akifyucedag/AEA_BMS/istikrar bmsarka.png

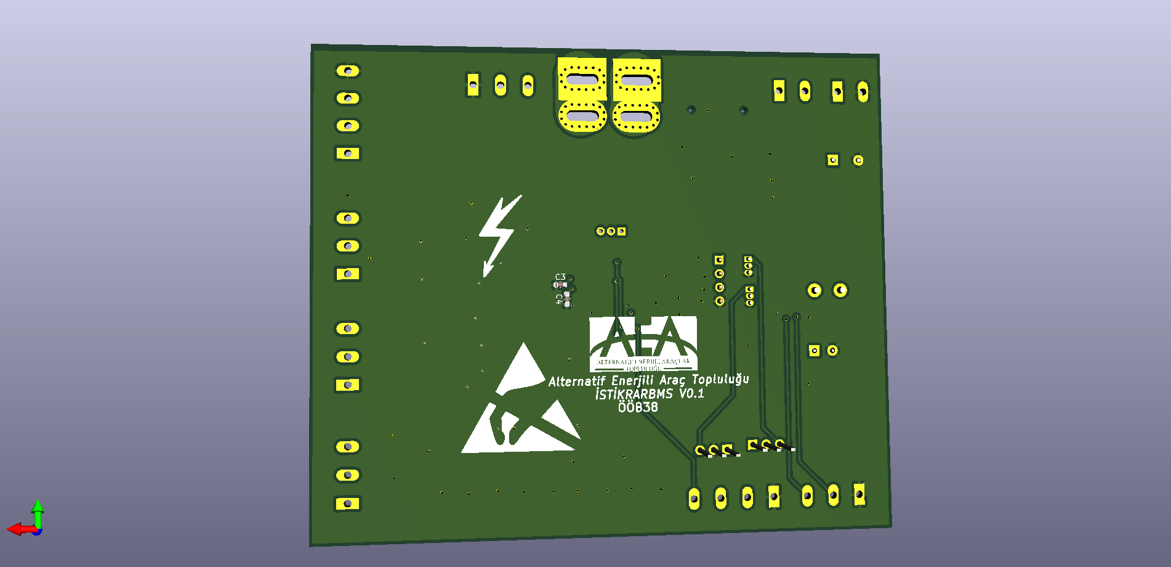
istikrar bmsarka.png
