akifyucedag/AEA_BMS/README.md

# AEA_BMS
iskenderun teknik üniversite  Alternatif araç topluluğu için hazırlamış olduğum 12s bms kartı
