akifyucedag/AEA_BMS/malzeme listesi 2.xlsx

reference | value | footprint | datashet |  |  |  |  | LİNK | QTY
C3 | 1uf63v | Capacitor_SMD:C_0603_1608Metric | ~ |  |  |  |  | https://ozdisan.com/pasif-komponentler/kondansatorler/smt-smd-ve-mlcc-kondansatorler/CL10A105KA8NNNC | 2 | o | t
C4 | 1uf63v | Capacitor_SMD:C_0603_1608Metric_Pad1.08x0.95mm_HandSolder | ~ |  |  |  |  | https://ozdisan.com/pasif-komponentler/kondansatorler/smt-smd-ve-mlcc-kondansatorler/CL10A105KA8NNNC | 2 | o | t
> C6, C8 | 18pf | Capacitor_SMD:C_0805_2012Metric_Pad1.18x1.45mm_HandSolder | ~ |  |  |  |  | https://www.ozdisan.com/pasif-komponentler/kondansatorler/smt-smd-ve-mlcc-kondansatorler/CL03C180GA3GNNC | 4 | o | t
> C1, C2, C5, C9 | 100nf | Capacitor_SMD:C_0603_1608Metric_Pad1.08x0.95mm_HandSolder | ~ |  |  |  |  | PRODUCT (https://www.ozdisan.com/pasif-komponentler/kondansatorler/smt-smd-ve-mlcc-kondansatorler/CL03C180GA3GNNC) | 6 | o | t
> C16, C29, C30 | 1uf | Capacitor_SMD:C_0603_1608Metric | ~ |  |  |  |  | PRODUCT (https://www.ozdisan.com/pasif-komponentler/kondansatorler/smt-smd-ve-mlcc-kondansatorler/CL10B105KQ8VPJC) | 5 | o | d
C18 | 10nf100v | Capacitor_SMD:C_1206_3216Metric_Pad1.33x1.80mm_HandSolder | ~ |  |  |  |  | https://ozdisan.com/pasif-komponentler/kondansatorler/smt-smd-ve-mlcc-kondansatorler/CL31B103KCCNNNC | 3 | o | d
> C15, C20, C35 | 10uf10V | Capacitor_SMD:C_0805_2012Metric_Pad1.18x1.45mm_HandSolder | ~ |  |  |  |  | PRODUCT (https://www.ozdisan.com/pasif-komponentler/kondansatorler/smt-smd-ve-mlcc-kondansatorler/CL21A106KPFNNNE) | 5 | o | d
> C10, C14, C25 | 100nf | Capacitor_SMD:C_1206_3216Metric_Pad1.33x1.80mm_HandSolder | ~ |  |  |  |  | PRODUCT (https://www.ozdisan.com/pasif-komponentler/kondansatorler/smt-smd-ve-mlcc-kondansatorler/CL31B104KBCNNND) | 5 | o | ş
C26 | 330uf | Capacitor_THT:CP_Radial_D10.0mm_P3.50mm | ~ |  |  |  |  |  | 2 | o | d
C31 | 100nf100v | Capacitor_SMD:C_1206_3216Metric_Pad1.33x1.80mm_HandSolder | ~ |  |  |  |  | PRODUCT (https://www.ozdisan.com/pasif-komponentler/kondansatorler/smt-smd-ve-mlcc-kondansatorler/CL31B104KCFNNNE) | 2 | o
> C7, C12, C13, C17, C19, C22-C24, C27, C28, C32 | 100nf100v | Capacitor_SMD:C_1206_3216Metric_Pad1.33x1.80mm_HandSolder | ~ |  |  |  |  | PRODUCT (https://www.ozdisan.com/pasif-komponentler/kondansatorler/smt-smd-ve-mlcc-kondansatorler/CL31B104KCFNNNE) | 15 | o
C33 | 100nf 100v | Capacitor_SMD:C_1206_3216Metric_Pad1.33x1.80mm_HandSolder | ~ |  |  |  |  | PRODUCT (https://www.ozdisan.com/pasif-komponentler/kondansatorler/smt-smd-ve-mlcc-kondansatorler/CL31B104KCFNNNE) | 2 | o
> C11, C34 | 100nf 25v | Capacitor_SMD:C_1206_3216Metric_Pad1.33x1.80mm_HandSolder | ~ |  |  |  |  | PRODUCT (https://www.ozdisan.com/pasif-komponentler/kondansatorler/smt-smd-ve-mlcc-kondansatorler/CL31B104KCFNNNE) | 4 | o
C36 | 22uf | Capacitor_SMD:C_0603_1608Metric_Pad1.08x0.95mm_HandSolder | ~ |  |  |  |  | PRODUCT (https://ozdisan.com/pasif-komponentler/kondansatorler/smt-smd-ve-mlcc-kondansatorler/CL10A226MQ8NRNC) | 1 | o | d
crystal1 | 8Mhz | Crystal:Crystal_SMD_HC49-SD_HandSoldering | ~ |  |  |  |  | PRODUCT (https://ozdisan.com/pasif-komponentler/kristaller-osilatorler-ve-rezanatorler/kristaller/AS-8-000-16-SMD-TR) | 2 | o | d
> D1-D12 | PDZ7.5B | PDZ7.5B:SOD2512X110N |  |  |  |  |  | PRODUCT (https://ozdisan.com/guc-yari-iletkenleri/diyotlar-modul-diyotlar-ve-dogrultucular/zener-diyotlar/PDZ7-5BR200001) | 16 | geliyor | d
D13 | MMSZ68V-HT | Diode_SMD:D_SOD-123 | ~ |  |  |  |  | PRODUCT (https://www.ozdisan.com/guc-yari-iletkenleri/diyotlar-modul-diyotlar-ve-dogrultucular/zener-diyotlar/MMSZ68V-HT) | 3 | o | d
D14 | 1N4148W-HT | Diode_SMD:D_SOD-123 | ~ |  |  |  |  | https://ozdisan.com/Product/Detail/417213/1N4148W-HT | 3 | o | d
> Ferritebead1, Ferritebead2 | BLM18PG330SN1D | Capacitor_SMD:C_0603_1608Metric_Pad1.08x0.95mm_HandSolder | ~ |  |  |  |  | https://ozdisan.com/Product/Detail/441411/BLM18PG330SN1D | 4 | geliyor | d
J1 | debug | Connector_PinHeader_2.54mm:PinHeader_1x04_P2.54mm_Vertical | ~ |  |  |  |  |  | 1 | o | d
J2 | fan kontrol | TerminalBlock:TerminalBlock_Altech_AK300-4_P5.00mm | ~ |  |  |  |  | PRODUCT (https://ozdisan.com/konnektor-ve-baglanti-elemanlari/klemensler/pcb-klemensler/GT301-5-0-12P-12-00AH) | 2 | o | d
> J3, J6-J9 | Screw_Terminal_01x03 | TerminalBlock:TerminalBlock_Altech_AK300-3_P5.00mm | ~ |  |  |  |  | PRODUCT (https://ozdisan.com/konnektor-ve-baglanti-elemanlari/klemensler/pcb-klemensler/WJ301-5-0-2P-14-00) | 6 | o | d
J4 | can port | TerminalBlock:TerminalBlock_Altech_AK300-2_P5.00mm | ~ |  |  |  |  | https://ozdisan.com/konnektor-ve-baglanti-elemanlari/klemensler/pcb-klemensler/GT126-5-0-03P-14-00AH | 2 | o | d
J5 | 30V vin | TerminalBlock:TerminalBlock_Altech_AK300-2_P5.00mm | ~ |  |  |  |  | https://ozdisan.com/konnektor-ve-baglanti-elemanlari/klemensler/pcb-klemensler/GT301-5-0-12P-12-00AH | 2 | o | d
J10 | Screw_Terminal_01x04 | TerminalBlock:TerminalBlock_Altech_AK300-4_P5.00mm | ~ |  |  |  |  | PRODUCT (https://ozdisan.com/konnektor-ve-baglanti-elemanlari/klemensler/pcb-klemensler/GT301-5-0-12P-12-00AH) | 2 | o | d
L2 | 100uh | Inductor_THT:L_Radial_D10.0mm_P5.00mm_Fastron_07M | ~ |  |  |  |  | PRODUCT (https://www.ozdisan.com/pasif-komponentler/induktorler/sabit-induktorler/LGB-E0608T-101K-1) | 3 | o | d
> Q4, Q5 | BD140 | Package_TO_SOT_THT:TO-126-3_Vertical | datasheet (http://www.st.com/internet/com/TECHNICAL_RESOURCES/TECHNICAL_LITERATURE/DATASHEET/CD00001225.pdf) |  |  |  |  |  | 3 | o | d
> Q6, Q7 | BC547 | Package_TO_SOT_THT:TO-92_Inline | datasheet (https://www.onsemi.com/pub/Collateral/BC550-D.pdf) |  |  |  |  |  | 3 | o | d
> Q1-Q3, Q8-Q16 | PJA3417 | Package_TO_SOT_SMD:SOT-23 | ~ |  |  |  |  | PRODUCT (https://www.ozdisan.com/guc-yari-iletkenleri/mosfetler/discrete-mosfetler/PJA3417R200001) | 15 | geliyor | t
R15 | 4.7M | Resistor_SMD:R_1206_3216Metric_Pad1.30x1.75mm_HandSolder | ~ |  |  |  |  | https://ozdisan.com/pasif-komponentler/direncler/smt-smd-ve-cip-direncler/1206S4F1004T5E | 2 |  | d
> R31, R33 | 100k | Resistor_SMD:R_1206_3216Metric_Pad1.30x1.75mm_HandSolder | ~ |  |  |  |  | PRODUCT (https://www.ozdisan.com/pasif-komponentler/direncler/smt-smd-ve-cip-direncler/CQ06S4F1003T5E) | 3 | o | d
> R35-R39, R41 | 1M | Resistor_SMD:R_0603_1608Metric_Pad0.98x0.95mm_HandSolder | ~ |  |  |  |  | PRODUCT (https://www.ozdisan.com/pasif-komponentler/direncler/smt-smd-ve-cip-direncler/1210S3F1004T5E) | 8 | o | t
> R1, R5, R9, R12, R16, R19, R22, R25, R28, R32, R42, R45 | 33R | Resistor_SMD:R_1812_4532Metric_Pad1.30x3.40mm_HandSolder | ~ |  |  |  |  | PRODUCT (https://www.ozdisan.com/pasif-komponentler/direncler/smt-smd-ve-cip-direncler/1812W2F330JT4E) | 15 | o | t
> R3, R8, R11, R14, R18, R21, R24, R27, R30, R40, R44, R47, R48,R6 | 100R | Resistor_SMD:R_0805_2012Metric_Pad1.20x1.40mm_HandSolder | ~ |  |  |  |  | PRODUCT (https://www.ozdisan.com/pasif-komponentler/direncler/smt-smd-ve-cip-direncler/25121WJ0101T4E) | 16 | o | t
> R2, R7, R10, R13, R17, R20, R23, R26, R29, R34, R43, R46, R49, R50 | 3.3k | Resistor_SMD:R_1206_3216Metric_Pad1.30x1.75mm_HandSolder | ~ |  |  |  |  | PRODUCT (https://www.ozdisan.com/pasif-komponentler/direncler/smt-smd-ve-cip-direncler/1206W4J0332T5E) | 16 | o | t
> R4, R51, R52 | 10k | Capacitor_SMD:C_0603_1608Metric_Pad1.08x0.95mm_HandSolder | ~ |  |  |  |  | PRODUCT (https://ozdisan.com/pasif-komponentler/direncler/smt-smd-ve-cip-direncler/PS03W4F1002T5E) | 5 | o | t
SW1 | SW_Push | Button_Switch_SMD:SW_SPST_TL3305C | ~ |  |  |  |  | PRODUCT (https://www.ozdisan.com/Product/Detail/611963/TL3305AF160QG) | 3 |  | d
U1 | LTC6803-2 | Package_SO:SSOP-44_5.3x12.8mm_P0.5mm | datasheet (https://www.analog.com/media/en/technical-documentation/data-sheets/680324fa.pdf) |  |  |  |  | PRODUCT (https://www.e-komponent.com/battery-battery-monitor-ic-multi-chemistry-44-ssop) | 2 | o | d
U2 | STM32F303CCTx | Package_QFP:LQFP-48_7x7mm_P0.5mm |  |  |  |  |  | https://ozdisan.com/Product/Detail/491919/STM32F303CCT6TR | 2 | o | d
U3 | ACS770LCB | Sensor_Current:Allegro_CB_PFF | datasheet (http://www.st.com/st-web-ui/static/active/en/resource/technical/document/datasheet/DM00058181.pdf) |  |  |  |  | PRODUCT (https://ozdisan.com/optolar-ve-sensorler/sensorler/hall-effect-sensorleri/ACS770LCB-100U-PFF-T) | 3 | o | d
U4 | ISO1050DUB | Package_SO:SOP-8_6.62x9.15mm_P2.54mm | datasheet (http://www.ti.com/lit/ds/symlink/iso1050.pdf) |  |  |  |  | https://ozdisan.com/Product/Detail/348272/ISO1050DUBR | 2 | o | d
U5 | LM1117-3.3 | Package_TO_SOT_SMD:SOT-223-3_TabPin2 | datasheet (http://www.ti.com/lit/ds/symlink/lm1117.pdf) |  |  |  |  | https://ozdisan.com/Product/Detail/423474/LM1117MPX-ADJNOPB | 2 | o | d
U6 | TL2575HV-33IKTTR | Package_TO_SOT_SMD:TO-263-5_TabPin6 |  |  |  |  |  | https://ozdisan.com/Product/Detail/526797/TL2575HV-33QKTTRQ1 | 2 | o | d
J12 | 112I-TDAR-R | 112I-TDAR-R:112ITDARR | datasheet (https://www.tme.eu/Document/1c9cd501982481d0bcdd4b50427971fa/112i-tdar-r.pdf) | Micro SD Socket | 2021-07-01 | ATTEND | 112I-TDAR-R | PRODUCT (https://ozdisan.com/konnektor-ve-baglanti-elemanlari/hafiza-konnektorleri/pc-kart-soketleri/112I-TDAR-R) | 2 | o | d
