akifyucedag/AEA_BMS/bms.pdf

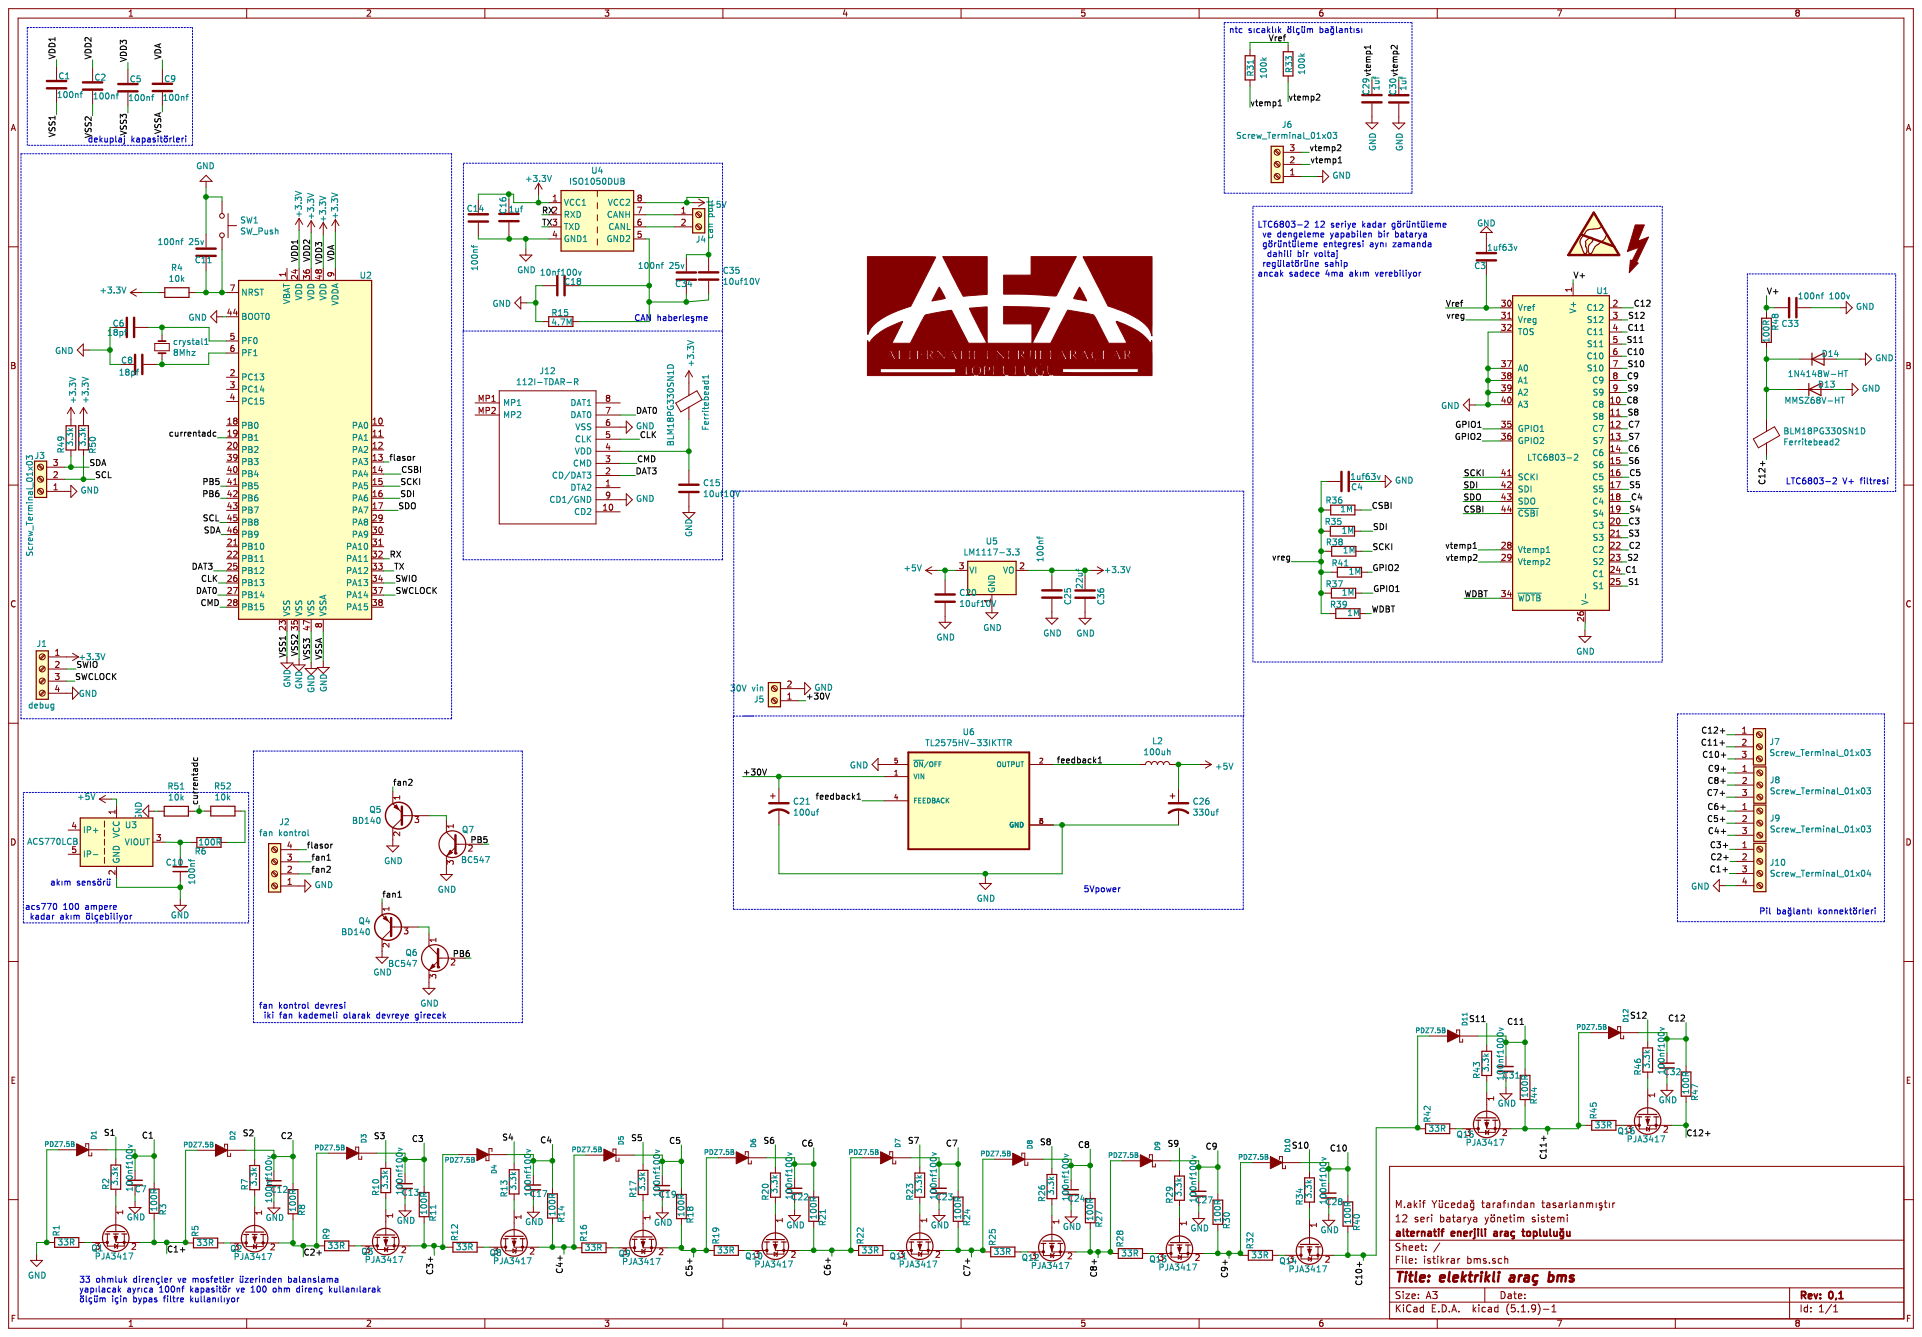
[picture p2: page 1]
