akifyucedag/AEA_BMS/istikrar bms.kicad_pcb

## KiCad design istikrar bms.kicad_pcb (2022-05-11)

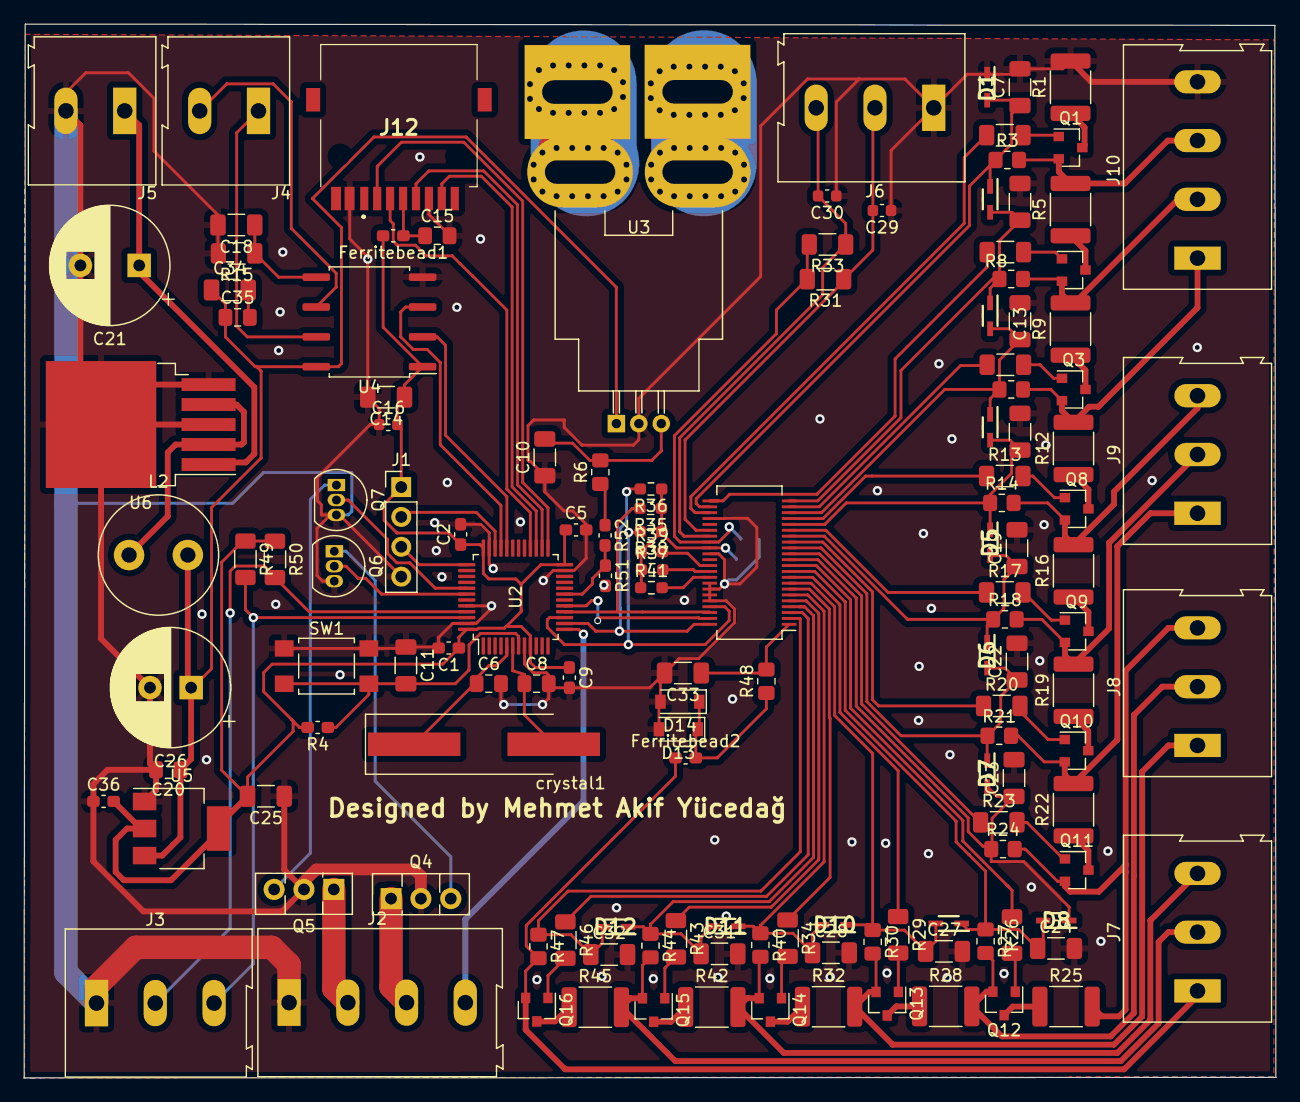
[picture p3: board istikrar bms.kicad_pcb from above]

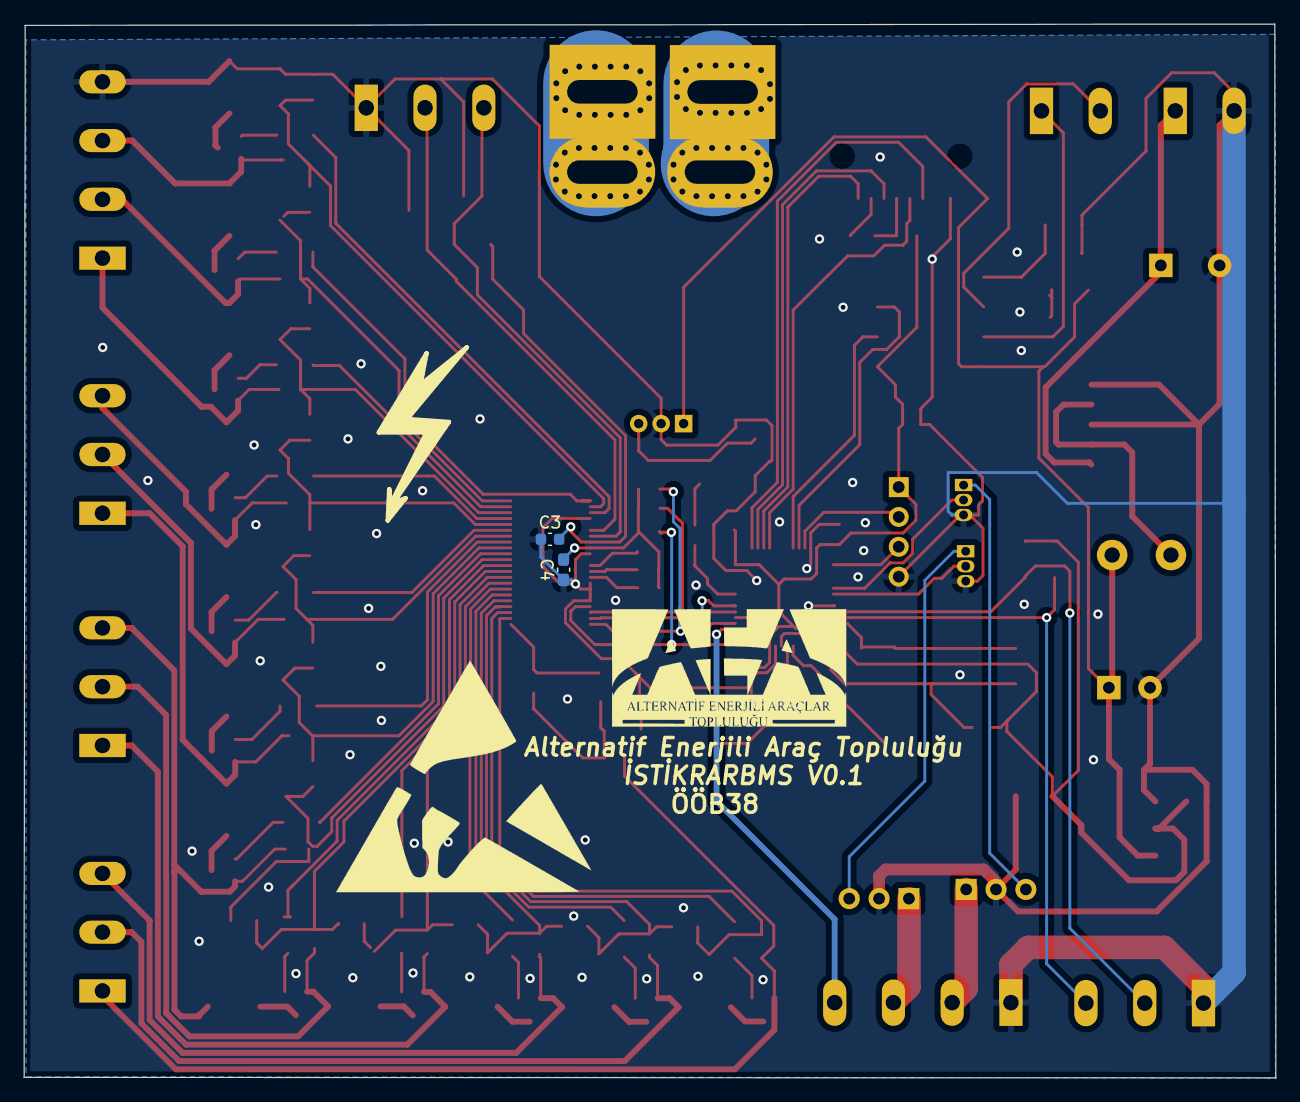
[picture p4: board istikrar bms.kicad_pcb from below]

Board: 2 copper layers, 106.5 x 89.7 mm, 141 parts (3 on the bottom side), 107 nets.

Parts:
 : Symbol_HighVoltage_Type1_CopperTop_Big
C1, C2, C5, C9: 100nf; C_0603_1608Metric_Pad1.08x0.95mm_HandSolder
C3: 1uf63v; C_0603_1608Metric
C4: 1uf63v; C_0603_1608Metric_Pad1.08x0.95mm_HandSolder
C6, C8: 18pf; C_0805_2012Metric_Pad1.18x1.45mm_HandSolder
C7, C12, C13, C17, C19, C22, C23, C24, C27, C28, C32: 100nf100v; C_1206_3216Metric_Pad1.33x1.80mm_HandSolder
C10, C14, C25: 100nf; C_1206_3216Metric_Pad1.33x1.80mm_HandSolder
C11, C34: 100nf 25v; C_1206_3216Metric_Pad1.33x1.80mm_HandSolder
C15, C20, C35: 10uf10V; C_0805_2012Metric_Pad1.18x1.45mm_HandSolder
C16, C29, C30: 1uf; C_0603_1608Metric
C18: 10nf100v; C_1206_3216Metric_Pad1.33x1.80mm_HandSolder
C21: 100uf; CP_Radial_D10.0mm_P5.00mm
C26: 330uf; CP_Radial_D10.0mm_P3.50mm
C31: 100nf1000v; C_1206_3216Metric_Pad1.33x1.80mm_HandSolder
C33: 100nf 100v; C_1206_3216Metric_Pad1.33x1.80mm_HandSolder
C36: 22uf; C_0603_1608Metric_Pad1.08x0.95mm_HandSolder
D1, D2, D3, D4, D5, D6, D7, D8, D9, D10, D11, D12: PDZ7.5B; SOD2512X110N
D13: MMSZ68V-HT; D_SOD-123
D14: 1N4148W-HT; D_SOD-123
Ferritebead1, Ferritebead2: BLM18PG330SN1D; C_0603_1608Metric_Pad1.08x0.95mm_HandSolder
J1: debug; PinHeader_1x04_P2.54mm_Vertical
J2: fan kontrol; TerminalBlock_Altech_AK300-4_P5.00mm
J3, J6, J7, J8, J9: Screw_Terminal_01x03; TerminalBlock_Altech_AK300-3_P5.00mm
J4: can port; TerminalBlock_Altech_AK300-2_P5.00mm
J5: 30V vin; TerminalBlock_Altech_AK300-2_P5.00mm
J10: Screw_Terminal_01x04; TerminalBlock_Altech_AK300-4_P5.00mm
J12: 112I-TDAR-R; 112ITDARR
L2: 100uh; L_Radial_D10.0mm_P5.00mm_Fastron_07M
Q1, Q2, Q3, Q8, Q9, Q10, Q11, Q12, Q13, Q14, Q15, Q16: PJA3417; SOT-23
Q4, Q5: BD140; TO-126-3_Vertical
Q6, Q7: BC547; TO-92_Inline
R1, R5, R9, R12, R16, R19, R22, R25, R28, R32, R42, R45: 33R; R_1812_4532Metric_Pad1.30x3.40mm_HandSolder
R2, R7, R10, R13, R17, R20, R23, R26, R29, R34, R43, R46, R49, R50: 3.3k; R_1206_3216Metric_Pad1.30x1.75mm_HandSolder
R3, R6, R8, R11, R14, R18, R21, R24, R27, R30, R40, R44, R47, R48: 100R; R_0805_2012Metric_Pad1.20x1.40mm_HandSolder
R4, R51, R52: 10k; C_0603_1608Metric_Pad1.08x0.95mm_HandSolder
R15: 4.7M; R_1206_3216Metric_Pad1.30x1.75mm_HandSolder
R31, R33: 100k; R_1206_3216Metric_Pad1.30x1.75mm_HandSolder
R35, R36, R37, R38, R39, R41: 1M; R_0603_1608Metric_Pad0.98x0.95mm_HandSolder
SW1: SW_Push; SW_SPST_TL3305C
U1: LTC6803-2; SSOP-44_5.3x12.8mm_P0.5mm
U2: STM32F303CCTx; LQFP-48_7x7mm_P0.5mm
U3: ACS770LCB; Allegro_CB_PFF
U4: ISO1050DUB; SOP-8_6.62x9.15mm_P2.54mm
U5: LM1117-3.3; SOT-223-3_TabPin2
U6: TL2575HV-33IKTTR; TO-263-5_TabPin6
crystal1: 8Mhz; Crystal_SMD_HC49-SD_HandSoldering

Connections:
+3V3: C1.1, C2.1, C5.1, C9.1, C14.1, C16.2, C25.2, C36.2, Ferritebead1.2, J1.1, R4.2, R49.1, R50.1, U2.9 (VDDA), U2.24 (VDD), U2.36 (VDD), U2.48 (VDD), U4.1 (VCC1), U5.2 (VO)
+5V: C20.1, C26.1, C34.1, C35.1, L2.2, U3.1 (VCC), U4.8 (VCC2), U5.3 (VI)
/+30V: C21.1, J5.1, U6.1 (VIN)
/C1: C7.1, D1.2 (K), D2.1 (A), R3.1, U1.24 (C1)
/C1+: J10.3, Q1.2 (S), R3.2, R5.2
/C2: D3.1 (A), R8.1, U1.22 (C2)
/C2+: J10.2, Q2.2 (S), R8.2, R9.2
/C3: C13.1, D3.2 (K), D4.1 (A), R11.1, U1.20 (C3)
/C3+: J10.1, Q3.2 (S), R11.2, R12.2
/C4: C17.1, D4.2 (K), D5.1 (A), R14.1, U1.18 (C4)
/C4+: J9.3, Q8.2 (S), R14.2, R16.2
/C5: C19.1, D5.2 (K), D6.1 (A), R18.1, U1.16 (C5)
/C5+: J9.2, Q9.2 (S), R18.2, R19.2
/C6: C22.1, D6.2 (K), D7.1 (A), R21.1, U1.14 (C6)
/C6+: J9.1, Q10.2 (S), R21.2, R22.2
/C7: C23.1, D7.2 (K), D8.1 (A), R24.1, U1.12 (C7)
/C7+: J8.3, Q11.2 (S), R24.2, R25.2
/C8: C24.1, D8.2 (K), D9.1 (A), R27.1, U1.10 (C8)
/C8+: J8.2, Q12.2 (S), R27.2, R28.2
/C9: D10.1 (A), R30.1, U1.8 (C9)
/C9+: J8.1, Q13.2 (S), R30.2, R32.2
/C10: C28.1, D10.2 (K), D11.1 (A), R40.1, U1.6 (C10)
/C10+: J7.3, Q14.2 (S), R40.2, R42.2
/C11: C31.1, D11.2 (K), D12.1 (A), R44.1, U1.4 (C11)
/C11+: J7.2, Q15.2 (S), R44.2, R45.2
/C12: C32.1, D12.2 (K), R47.1, U1.2 (C12)
/C12+: Ferritebead2.1, J7.1, Q16.2 (S), R47.2
/CLK: J12.5 (CLK), U2.26 (PB13)
/CMD: J12.3 (CMD), U2.28 (PB15)
/CSBI: R36.2, U1.44 (~CSBI), U2.14 (PA4)
/DAT0: J12.7 (DAT0), U2.27 (PB14)
/DAT3: J12.2 (CD/DAT3), U2.25 (PB12)
/GPIO1: R37.2, U1.35 (GPIO1)
/GPIO2: R41.2, U1.36 (GPIO2)
/PB5: Q7.2 (B), U2.41 (PB5)
/PB6: Q6.2 (B), U2.42 (PB6)
/RX: U2.32 (PA11), U4.2 (RXD)
/S1: R2.1, U1.25 (S1)
/S2: R7.1, U1.23 (S2)
/S3: R10.1, U1.21 (S3)
/S4: R13.1, U1.19 (S4)
/S5: R17.1, U1.17 (S5)
/S6: R20.1, U1.15 (S6)
/S7: R23.1, U1.13 (S7)
/S8: R26.1, U1.11 (S8)
/S9: R29.1, U1.9 (S9)
/S10: R34.1, U1.7 (S10)
/S11: R43.1, U1.5 (S11)
/S12: R46.1, U1.3 (S12)
/SCKI: R38.2, U1.41 (SCKI), U2.15 (PA5)
/SCL: J3.2, R50.2, U2.45 (PB8)
/SDA: J3.3, R49.2, U2.46 (PB9)
/SDI: R35.2, U1.42 (SDI), U2.16 (PA6)
/SDO: U1.43 (SDO), U2.17 (PA7)
/SWCLOCK: J1.3, U2.37 (PA14)
/SWIO: J1.2, U2.34 (PA13)
/TX: U2.33 (PA12), U4.3 (TXD)
/V+: C33.1, R48.2, U1.1 (V+)
/Vref: C3.2, R31.2, R33.2, U1.30 (Vref)
/WDBT: R39.2, U1.34 (~WDTB)
/currentadc: R51.1, R52.2, U2.19 (PB1)
/fan1: J2.3, Q4.1 (E)
/fan2: J2.2, Q5.1 (E)
/feedback1: L2.1, U6.2 (OUTPUT), U6.4 (FEEDBACK)
/flasor: J2.4, U2.13 (PA3)
/vreg: C4.2, R35.1, R36.1, R37.1, R38.1, R39.1, R41.1, U1.31 (Vreg)
/vtemp1: C29.2, J6.2, R31.1, U1.28 (Vtemp1)
/vtemp2: C30.2, J6.3, R33.1, U1.29 (Vtemp2)
GND: C1.2, C2.2, C3.1, C4.1, C5.2, C6.2, C7.2, C8.2, C9.2, C10.1, C11.1, C12.2, C13.2, C14.2, C15.2, C16.1, C17.2, C18.2, C19.2, C20.2, C21.2, C22.2, C23.2, C24.2, C25.1, C26.2, C27.2, C28.2, C29.1, C30.1, C31.2, C32.2, C33.2, C36.1, D1.1 (A), D13.2 (A), D14.2 (A), J1.4, J2.1, J3.1, J5.2, J6.1, J10.4, J12.6 (VSS), J12.9 (CD1/GND), Q4.2 (C), Q5.2 (C), Q6.3 (E), Q7.3 (E), R1.2, R15.2, R51.2, SW1.1, U1.26 (V-), U1.32 (TOS), U1.37 (A0), U1.38 (A1), U1.39 (A2), U1.40 (A3), U2.8 (VSSA), U2.23 (VSS), U2.35 (VSS), U2.44 (BOOT0), U2.47 (VSS), U3.2 (GND), U4.4 (GND1), U5.1 (GND), U6.3 (GND), U6.5 (~ON/OFF), U6.6 (GND)
unnamed: C6.1, U2.5 (PF0), crystal1.1
unnamed: C8.1, U2.6 (PF1), crystal1.2
unnamed: C10.2, R6.2, U3.3 (VIOUT)
unnamed: C11.2, R4.1, SW1.2, U2.7 (NRST)
unnamed: C12.1, D2.2 (K)
unnamed: C15.1, Ferritebead1.1, J12.4 (VDD)
unnamed: C18.1, C34.2, C35.2, R15.1, U4.5 (GND2)
unnamed: C27.1, D9.2 (K)
unnamed: D13.1 (K), D14.1 (K), Ferritebead2.2, R48.1
unnamed: J4.1, U4.7 (CANH)
unnamed: J4.2, U4.6 (CANL)
unnamed: Q1.1 (G), R2.2
unnamed: Q1.3 (D), R1.1
unnamed: Q2.1 (G), R7.2
unnamed: Q2.3 (D), R5.1
unnamed: Q3.1 (G), R10.2
unnamed: Q3.3 (D), R9.1
unnamed: Q4.3 (B), Q6.1 (C)
unnamed: Q5.3 (B), Q7.1 (C)
unnamed: Q8.1 (G), R13.2
unnamed: Q8.3 (D), R12.1
unnamed: Q9.1 (G), R17.2
unnamed: Q9.3 (D), R16.1
unnamed: Q10.1 (G), R20.2
unnamed: Q10.3 (D), R19.1
unnamed: Q11.1 (G), R23.2
unnamed: Q11.3 (D), R22.1
unnamed: Q12.1 (G), R26.2
unnamed: Q12.3 (D), R25.1
unnamed: Q13.1 (G), R29.2
unnamed: Q13.3 (D), R28.1
unnamed: Q14.1 (G), R34.2
unnamed: Q14.3 (D), R32.1
unnamed: Q15.1 (G), R43.2
unnamed: Q15.3 (D), R42.1
unnamed: Q16.1 (G), R46.2
unnamed: Q16.3 (D), R45.1
unnamed: R6.1, R52.1
